leonlee-scut/PSU24_for_FAN/README.md

# PSU24 for FAN

用于BLDC直流风扇的24V电源。

该电源模块具有以下特点：

- 输入电压范围：DC 300V-800V
- 输出电压：DC 24V
- 输出功率：最大200W
- 效率：高达90%
- 保护功能：过压、过流、短路保护
- 适用4线风扇调速

## 修改记录

- 2024-11-11 V1.0 初版，测试电源可输出最大功率200W；驱动芯片L6565D供电不稳，造成带载启动困难。
