leonlee-scut/PSU24_for_FAN/Release/20250621/20250621-BOM of PSU24_for_FAN.xls

Sheet: BOM Report
 | 元件清单 |  | Bill of Materials for Project [PSU24_for_FAN.PrjPcb] (No PCB Document Selected)
 |  | Source Data From: | PSU24_for_FAN.PrjPcb
 |  | Project: | PSU24_for_FAN.PrjPcb
 |  | Variant: | None
 |  | Creation Date: | 2025/06/21 | 21:55 |  | Production Quantity: | 1
 |  | Print Date: | 2025-06-21 | 21:55:58 |  | Currency | USD
序号 | Quantity | Comment | Footprint | Designator | 名称 | 型号 | 备注
1 | 3 | 4.7uF | CAPC1206N | C16, C20, C21 | 贴片电容 | X7R-50V-1206-10% | X7R/X5R系列
2 | 1 | 10nF | CAPC1206N | C1 | 贴片电容 | X7R-50V-1206-10% | X7R/X5R系列
3 | 1 | 10uF | CAPC1206N | C8 | 贴片电容 | X7R-25V-1206-10% | X7R/X5R系列
4 | 2 | 33pF | CAPC1206N | C2, C3 | 贴片电容 | X7R-50V-1206-10% | X7R/X5R系列
5 | 1 | 33pF/1kV | CAPC1206N | C11 | 贴片电容 | CC1206JKNPOCBN330 | NPO系列，1kV，5%
6 | 6 | 100nF | CAPC1206N | C4, C5, C17, C23, C24, C25 | 贴片电容 | X7R-50V-1206-10% | X7R/X5R系列
7 | 1 | 100pF | CAPC1206N | C7 | 贴片电容 | X7R-50V-1206-10% | X7R/X5R系列
8 | 3 | 2.2nF/Y1 | CAPRD10-10x5 | C10, C18, C19 | 交流陶瓷安规电容 | Y1-400Vac-10% | 10mm脚距
9 | 1 | 470nF/1000V | PCM27.5-W17 | C9 | 金属化聚丙烯薄膜电容 | CBB-1000V-10% | 脚距27.5mm，厚17mm
10 | 1 | 47uF/50V | RB2.5M/D6.3 | C6 | 电解电容 | RUBYCON-YK | Ø6.3x12mm，脚距2.5mm
11 | 5 | 1000uF/35V | RB5M/D10 | C12, C13, C14, C15, C22 | 电解电容 | RUBYCON-YK | Ø10x20mm，脚距5mm
12 | 4 | US1MF | SMAF | D1, D2, D7, D10 | 贴片二极管 | 1A/1000V/快恢复 | SMAF封装
13 | 4 | DSK110 | SMF-N-1K2A | D3, D4, D9, D18 | 贴片肖特基二极管 | 1A/100A/SMF | SMF或SOD-123FL封装
14 | 2 | 1N4148W | SOD-123 - 1K2A | D5, D8 | 贴片二极管 | 1N4148W/SOD123 | SOD-123封装
15 | 1 | MUR3020PT | TO-247-3_Vertical | D12 | 快恢复二极管 | 200V/30A/TO-247 | TO-247，共阴极
16 | 4 | SMF5V0A-E3-08 | SMF-N | D14, D15, D16, D17 | 贴片ESD二极管 | SMF-5V-单向 | Vishay, SMF-TVS
17 | 1 | PESD5V2S2UT | SOT-23_N | D11 | 贴片ESD二极管 | 5V，双路，单向 | SOT23封装，单向TVS
18 | 2 | D3-GRN | LED-D3 | D6, D13 | 发光二极管 | Ø3-绿色 | 雾状透镜
19 | 2 | BZD27C16P-E3-08 | SOD-123 - 1K2A | Z2, Z3 | 贴片稳压二极管 | 16V/0.5W/SOD123 | SOD-123封装
20 | 1 | BZD27C43P-E3-08 | SOD-123 - 1K2A | Z1 | 贴片稳压二极管 | 43V/0.5W/SOD123 | SOD-123封装
21 | 3 | HS-TO247-42x25x40 | HEATSINK_TO220_Vertical_42x25x38 | HS1, HS2, HS3 | 铝散热器 | TO247-42x25x40 | 表面发黑
22 | 1 | EL3H7C | FP-EL3H7-G-MFG | U2 | 贴片集成电路 | EL3H7C | Everlight(亿光)
23 | 1 | TL431BIDBVT | SOT23-5_N | U3 | 贴片集成电路 | TL431BIDBVT | SOT23-5封装
24 | 1 | BEAD-1206-600R | RESC1206N | FB1 | 贴片磁珠电感 | BEAD-1206-600R
25 | 1 | 0R | RESC1206N | R15 | 贴片电阻 | CR1206-1% | 风华或国巨
26 | 1 | 1K | RESC1206N | R10 | 贴片电阻 | CR1206-1% | 风华或国巨
27 | 7 | 1.8M | RESC1206N | R1, R2, R3, R4, R5, R6, R7 | 贴片电阻 | CR1206-1% | 风华或国巨
28 | 1 | 2.2K | RESC1206N | R9 | 贴片电阻 | CR1206-1% | 风华或国巨
29 | 1 | 2.7K | RESC1206N | R13 | 贴片电阻 | CR1206-1% | 风华或国巨
30 | 2 | 5.1K | RESC1206N | R12, R14 | 贴片电阻 | CR1206-1% | 风华或国巨
31 | 2 | 7.5K | RESC1206N | R8, R27 | 贴片电阻 | CR1206-1% | 风华或国巨
32 | 7 | 10K | RESC1206N | R11, R24, R25, R29, R41, R44, R46 | 贴片电阻 | CR1206-1% | 风华或国巨
33 | 1 | 33K | RESC1206N | R16 | 贴片电阻 | CR1206-1% | 风华或国巨
34 | 1 | 39K | RESC1206N | R21 | 贴片电阻 | CR1206-1% | 风华或国巨
35 | 2 | 47R | RESC1206N | R22, R23 | 贴片电阻 | CR1206-1% | 风华或国巨
36 | 4 | 75K | RESC1206N | R17, R18, R19, R20 | 贴片电阻 | CR1206-1% | 风华或国巨
37 | 4 | 100R | RESC1206N | R33, R34, R37, R38 | 贴片电阻 | CR1206-1% | 风华或国巨
38 | 1 | R500 | RESC1225N | R26 | 贴片电阻 | CR1206-1% | 风华或国巨
39 | 1 | 2920L100/33 | PTC2920N | R39 | 贴片可恢复保险 | 1A/33V/2920
40 | 2 | 2920L250/33 | PTC2920N | R31, R40 | 贴片可恢复保险 | 2.5A/33V/2920
41 | 1 | 1812L050/24 | PTCC1812N | R28 | 贴片可恢复保险 | 0.5A/24V/1812
42 | 1 | ETD39-8+8-H | ETD39-8+8pins | T2 | 变压器 | ETD39-8+8卧式 | 按图纸加工
43 | 1 | DRT801-111 | TRANS-DRT801-1+1+1 | T1 | 脉冲变压器 | DRT801-1111 | 北京耀华德昌
44 | 2 | MS12N100FC | TO-247-3_Vertical | Tr1, Tr2 | 场效应管 | 1000V/12A/TO-247
45 | 1 | CJ88120 | FP-SOT89-MFG | U5 | 贴片集成电路 | CJ88120 | SOT89封装，12V@150mA
46 | 1 | L6565D | SOIC-8N | U1 | 贴片集成电路 | L6565D | ST
47 | 1 | U_FAN_CON_MOD | U_FAN_CON | U4 | 专用厚膜集成电路 |  | 定制
48 | 1 | JST-B2P-VH | B2P-VH | X2 | 接插件 | B2P-VH | JST
49 | 1 | JST-B4P-VH | B4P-VH | X1 | 接插件 | B4P-VH | JST
50 | 4 | WF2541-WS02E01 | WF2541-WSXX01-2PIN | X5, X6, X7, X8 | 接插件 | WF2541-WS02E01 | 2.54间距，2pin
51 | 1 | WF2541-WS03E01 | WF2541-WSXX01-3PIN | X9 | 接插件 | WF2541-WS03E01 | 2.54间距，3pin
52 | 2 | WF2541-WS04E01 | WF2541-WSXX01-4PIN | X3, X4 | 接插件 | WF2541-WS04E01 | 2.54间距，4pin
 | 107
批准： |  |  | 日期： |  | 备注：

Sheet: Project Information
Project Full Path | C:\Users\Leon\Documents\Design\SiC Inverter Project\PSU\PSU24_for_FAN\PSU24_for_FAN.PrjPcb
Project Filename | PSU24_for_FAN.PrjPcb
Variant Name | None
Data-Source Filename | PSU24_for_FAN.PrjPcb
Data-Source Full Path | C:\Users\Leon\Documents\Design\SiC Inverter Project\PSU\PSU24_for_FAN\PSU24_for_FAN.PrjPcb
Title | Bill of Materials for Project [PSU24_for_FAN.PrjPcb] (No PCB Document Selected)
Total Quantity | 107
Report Time | 21:55
Report Date | 2025/06/21
Report Date & Tine | 2025/06/21 21:55
Output Name | Bill of Materials
Output Type | BomReport
Output Generator Name | BOM
Output Generator Description | Bill of Materials
