leonlee-scut/PSU24_for_FAN/Release/20241111/PSU24_for_FAN.pdf

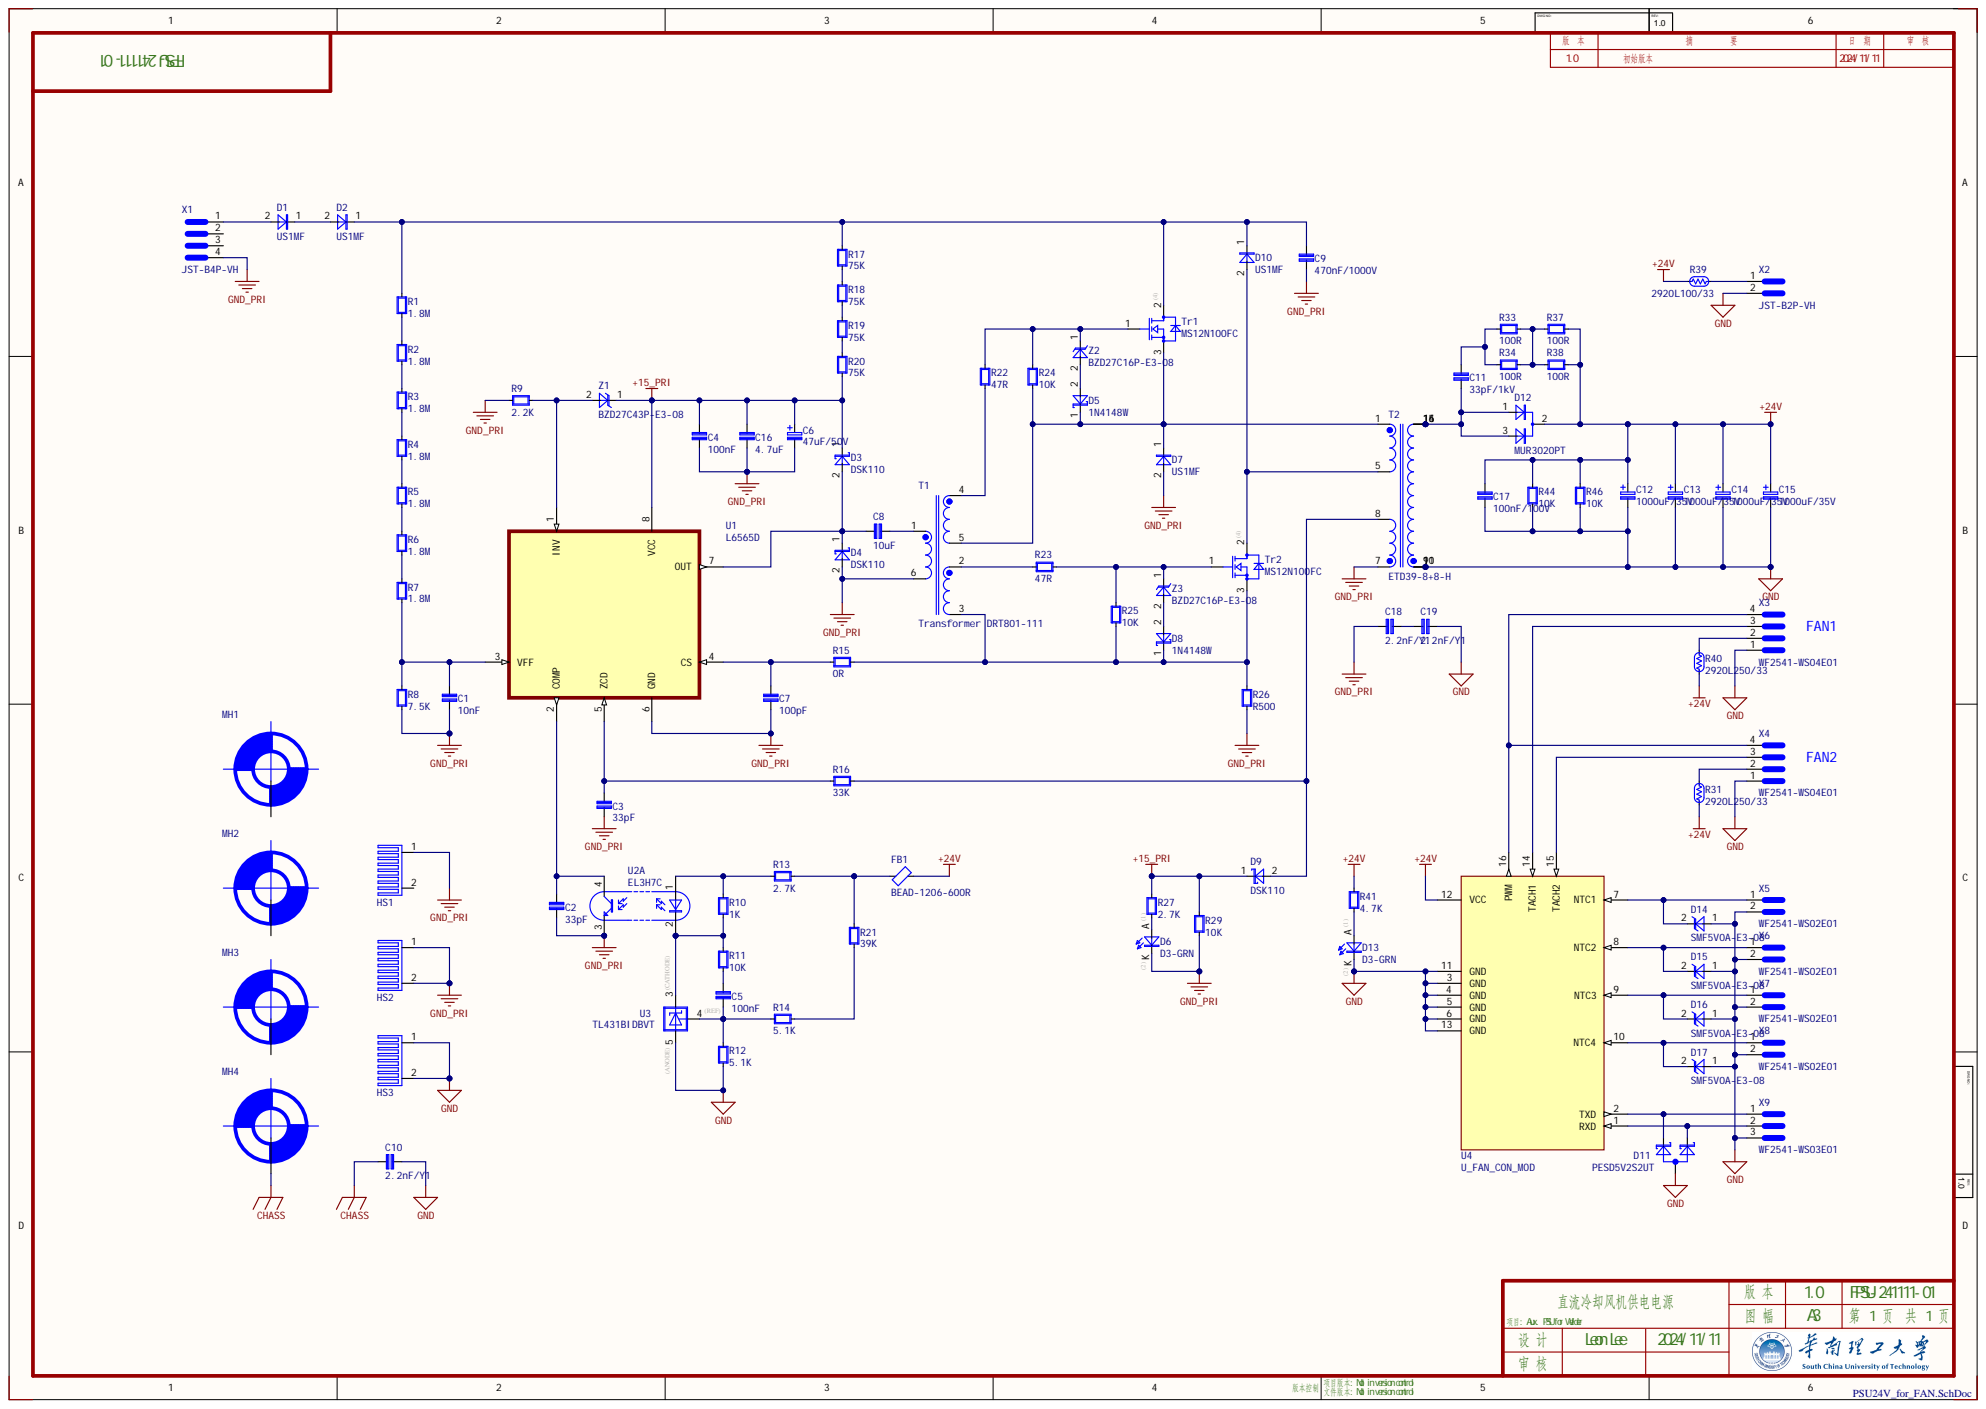
[picture p1: page 1]

版 本 | 摘 要 | 日 期 | 审 核
1 . 0 | 初始 版 本 | 2024/ 1 1 / 1 1

项目 : Aux. PSU for Welder | 版 本 | 1 . 0A3 直流冷却风机供电电源 LeonLee | FPSU-241 1 1 1 -01

设 计 | | 2024/ 1 1 / 1 1
审 核

control 文件版本: Not inversioncontrol

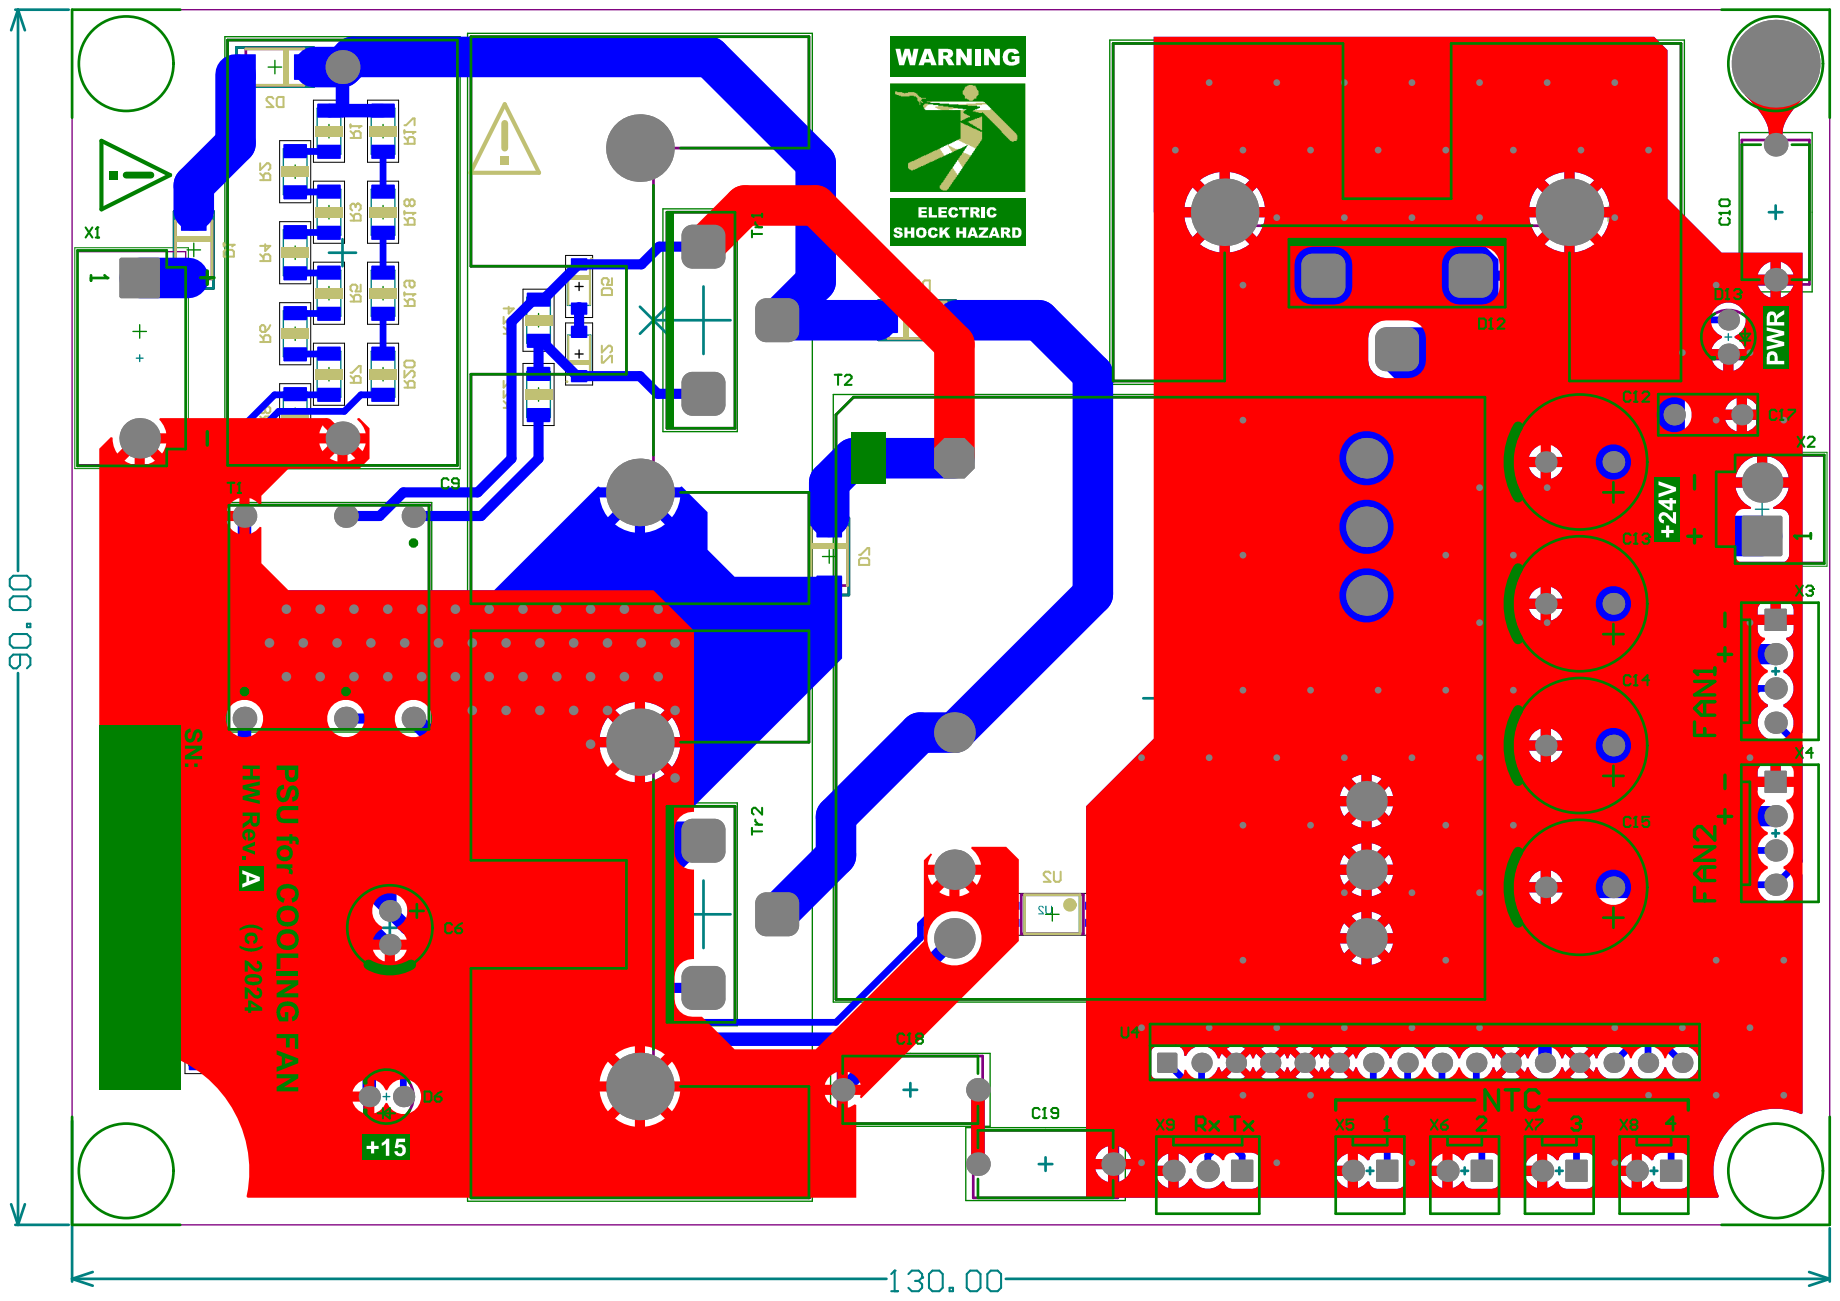
[picture p2: page 2]
