leonlee-scut/PSU24_for_FAN/Release/20250621/20250621-PSU24_for_FAN.pdf

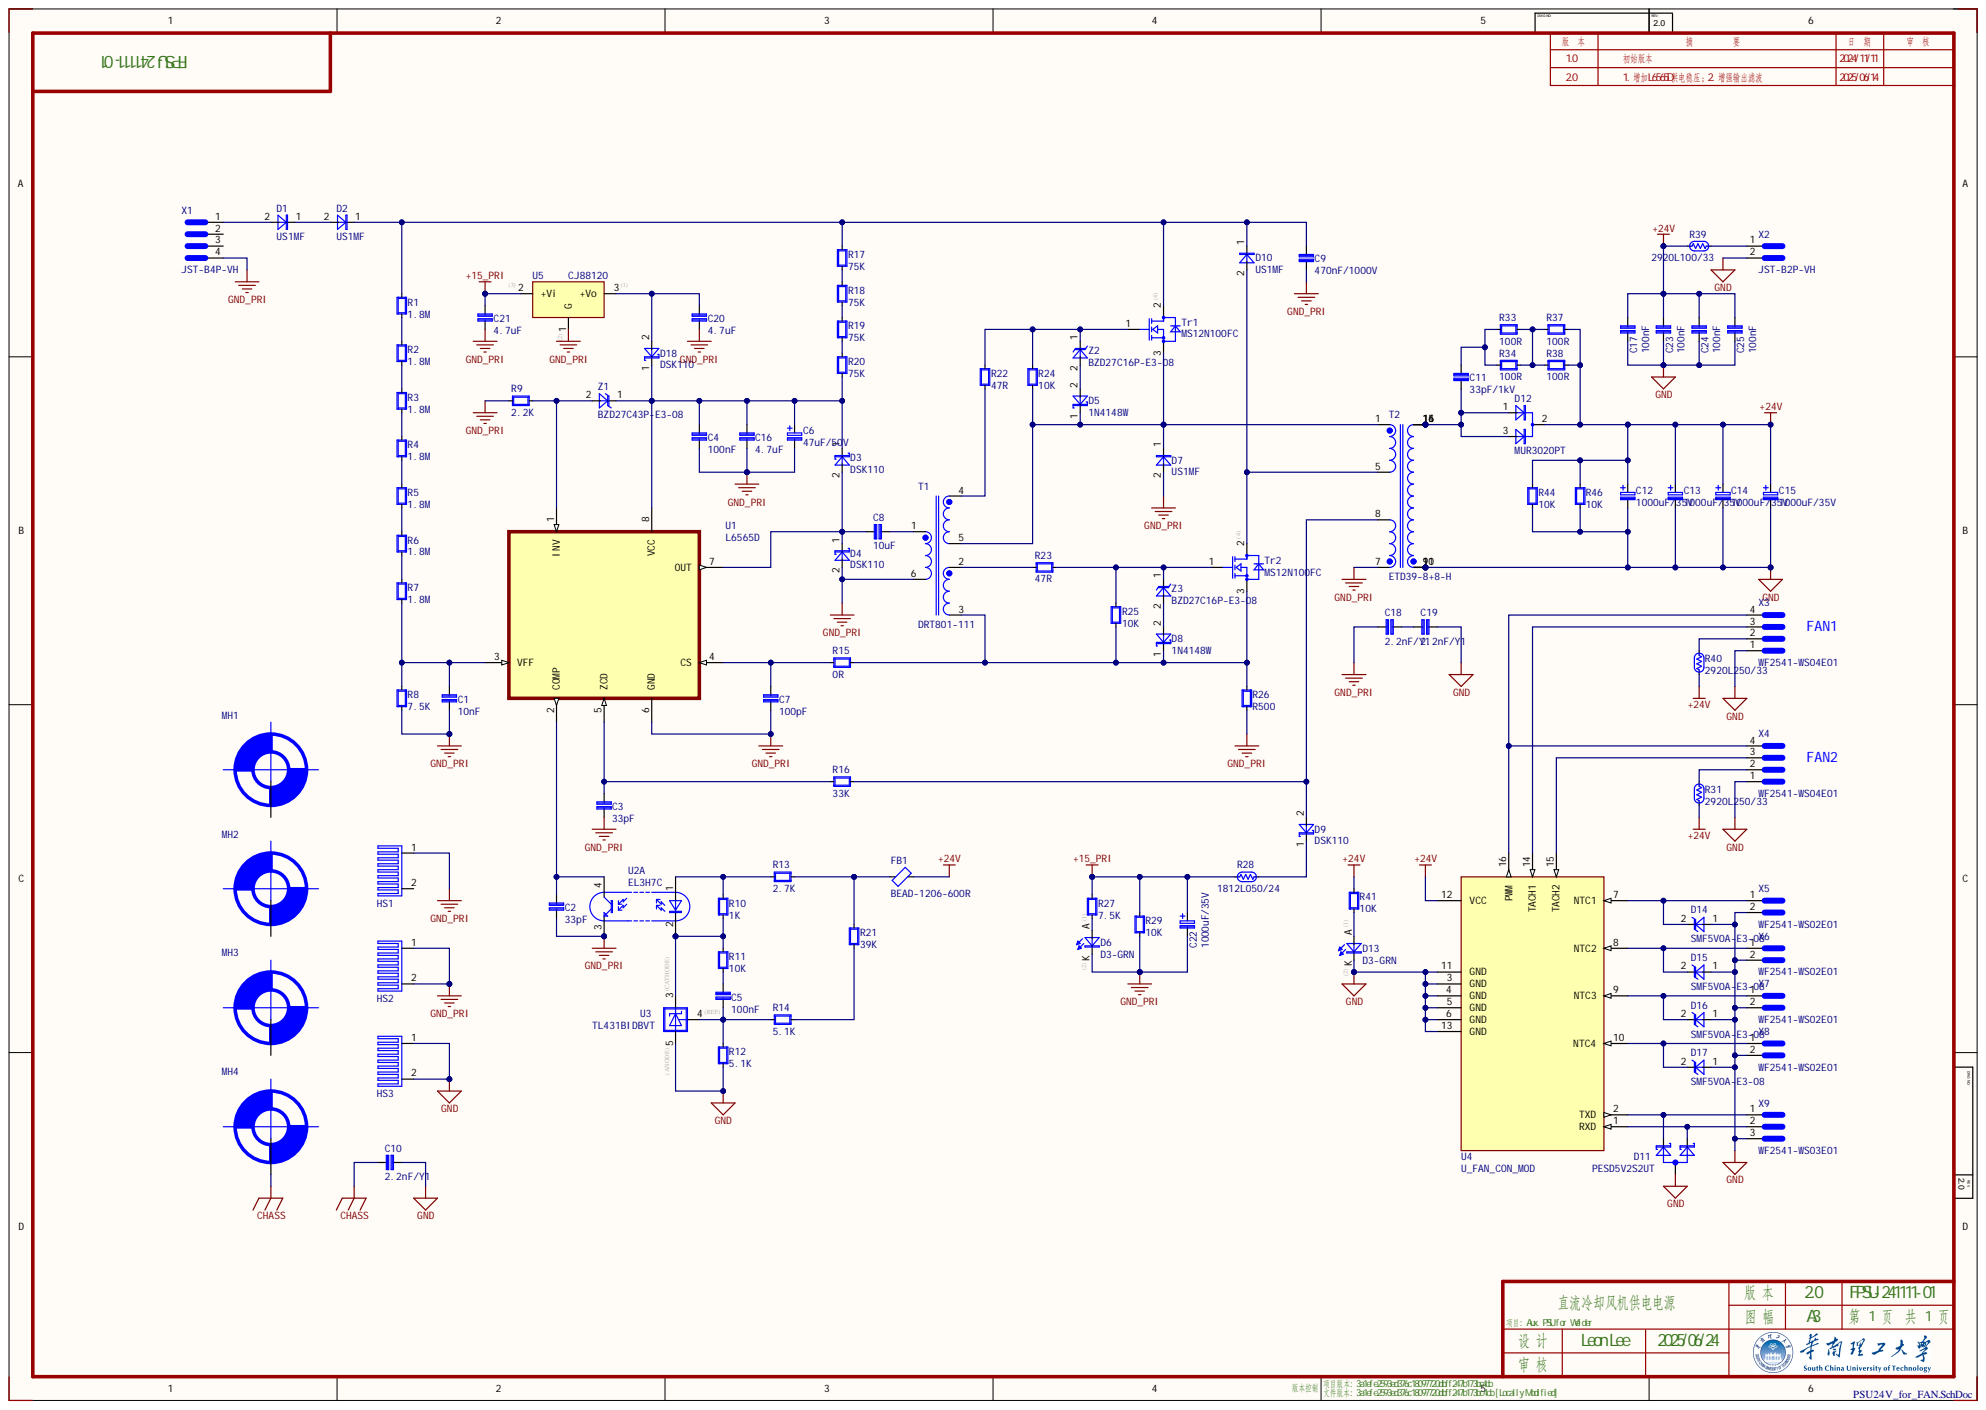
[picture p3: page 1]

D W G NO : | REV : 2 . 0

版 本 | 摘 要 | 日 期 | 审 核
1 . 0 | 初 始 版 本 | 2024/1 1/1 1
2. 0 | 1 . 增 加 L6565D供 电 稳 压 ； 2. 增 强 输 出 滤 波 | 2025/06/1 4

项目 : Aux. PSU for Wel der | 本 版 | 2. 0A3 直流冷却风机供电电源 LeonLee | FPSU-241 1 1 1 -01

设 计 | | 2025/06/24
审 核

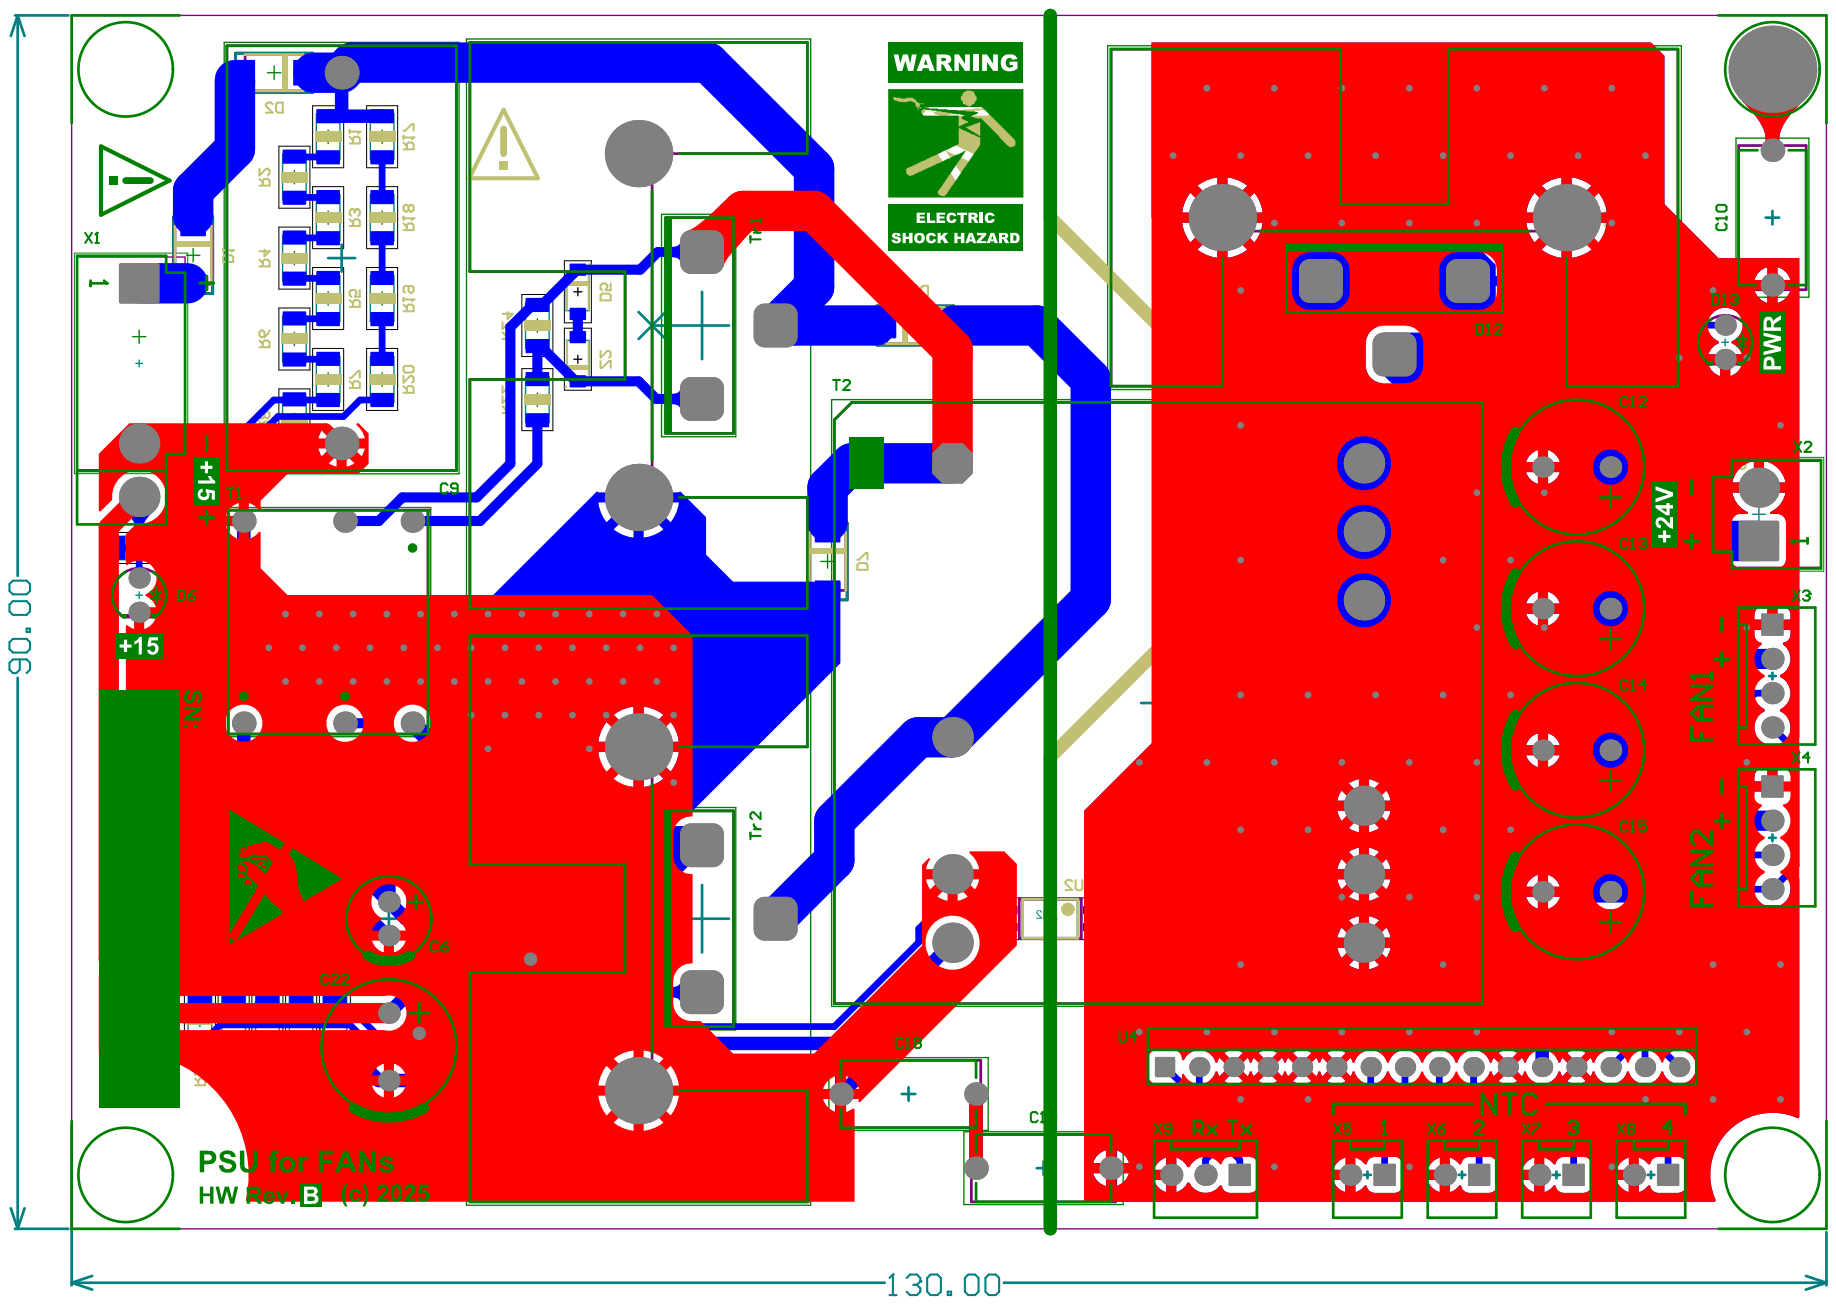
[picture p4: page 2]
