leonlee-scut/PSU24_for_FAN/(list of files, drawings)

Other design files:
Pcb/PSU24_for_FAN.PcbLib
PSU24_for_FAN.PrjPcb
Sch/PSU24V_for_FAN.SchDoc
