leonlee-scut/PSU24_for_FAN/(commit log)

2025-06-14 初次版本
    [20241111-BOM of PSU24_for_FAN.xls, PSU24V_for_FAN.SchDoc, PSU24_for_FAN.PcbLib, PSU24_for_FAN.PrjPcb]
2025-06-21 原理图版本升级为2.0，PCB版本升级为Rev.B。 1. 改善L6565D芯片供电，解决带载启动困难问题； 2. 增强+24V输出滤波。 3. 修正一些布线问题。
    [20250621-BOM of PSU24_for_FAN.xls, PSU24V_for_FAN.SchDoc, PSU24_for_FAN.PrjPcb]
